MusaMahmood/PCB_nRF52_GSR_recharge/GSR_v1.kicad_pcb

## KiCad design GSR_v1.kicad_pcb (2019-05-02)

Schematic: GSR_v1.sch

Parts:
A1: CHIP-ANT
C1, C9, C10, C14, C15: 10uF; C_0402
C2: 22uF; C_0402
C3, C4, C5, C26, C33: 100nF; C_0402
C6, C7, C8, C11: 0.1uF; C_0402
C16, C17: 4.7uF; C_0402
C18: 1.0uF; C_0402
C21: 4.7µF; C_0402
C22: 100nF; C_0603
C23: 1.0µF; C_0603
C24, C25, C28, C29: 12pF; C_0402
C27: N.C.
C30: 1.0pF; C_0402
C34: 100pF; C_0402
D1, D3: LED; LED_0603
D4: D_Schottky; LED_0603
F1: 2450FM07A0029
IC1: AD5242BRUZ1M; SOP65P640X120-16N; Mouser Part Number 584-AD5242BRUZ1M
J1: Micro_SD_Card_Det
L1: 2.20µH; L_0603
L2: 4.7uH; L_0603
L3: 15nH; L_0402
L4: 10uH; L_0603
L5: 2.7nH; L_0402
L6: 3.9nH; L_0402
P1, P2, P3, P4: CONN_2; Pin_Header_Straight_1x02_Pitch2.54mm
Q1: DMP21D5UFB4-7B; X2-DFN1006
R1, R2, R4, R16, R17, R18, R19: 4.7k; R_0402
R3, R6, R13, R14: 200k; R_0402
R5, R7, R15: 1M; R_0402
R8: N.C.; R_0402
R9: 2k; R_0402
R10, R11, R12: 100k; R_0402
R20: 1k; R_0402
S1: SSAJ120100; Mouser Part Number 688-SSAJ120100
U1: TPS63001
U2: LM324N
U3: NRF528XX-QFAA; UQFN-48-1EP_6x6mm_Pitch0.4mm
U4: TMP116
U5: TPS2294x
U6: MCP73831; DFN-8-1EP_2x3mm_Pitch0.5mm
U7: ADS1220; QFN-16-1EP_3x3mm_P0.5mm_EP1.8x1.8mm
U8: TPS61222; SOT-363_SC-70-6
U9: 4050; SOIC127P600X175-16N
X1: Crystal_GND24; Crystal_SMD_2016-4pin_2.0x1.6mm
X2: 32.768 kHz; Crystal_SMD_2012-2pin_2.0x1.2mm

Connections:
5V_in_charge: C16.1, D4.2, P3.1, Q1.1, R10.1, U6.1 (Vdd), U6.2 (Vdd)
/AD5242_SCL: IC1.7, R19.1, U3.21 (P0.18/TD[0]/SWO)
/AD5242_SDA: IC1.8, R4.1, U3.20 (P0.17)
/ADC_AIN0: C5.2, R15.1, U7.9
/AIN_BAT_DIV_VOLTAGE: R5.1, R7.2, U3.6 (P0.04/AIN2)
/BATT_IN: C17.1, P1.1, Q1.2, U6.3 (Vbat), U6.4 (Vbat)
/CMD_MOSI: U3.28 (P0.23), U9.3
/DAT0_MISO: J1.7, U3.24 (P0.21/nRESET)
/DAT1_UNUSED: J1.8
/DAT2_UNUSED: J1.1
/DAT3_CS: R20.1, U3.29 (P0.24), U9.9
/DEC1: C26.1, U3.1 (DEC1)
/DEC2: C27.1, U3.32 (DEC2)
/DEC3: C34.1, U3.33 (DEC3)
/DIN: U3.16 (P0.13), U7.14
/DOUT: U3.17 (P0.14/TRACEDATA[3]), U7.13
/ELECTRODE_INPUT: IC1.3, P4.1, U2.5 (+)
/LOAD_IN: C15.1, C18.2, D4.1, Q1.3, R8.2, S1.1, U5.5 (Vin)
/LOAD_SW_CTRL: U3.5 (P0.03/AIN1), U5.4 (ON)
/RF: C30.1, F1.4 (OUT)
/RT_1: C3.2, IC1.2, R1.1, R2.2, R3.2
/SPI_SCLK: U3.15 (P0.12), U7.15
/SPI_~CS: U3.14 (P0.11), U7.16
/SWDCLK: P2.1, U3.25 (SWDCLK)
/SWDIO: P2.2 (PM), U3.26 (SWDIO)
/TMP_ALERT: R18.1, U4.3 (ALERT)
/TMP_SCL: R17.1, U3.22 (P0.19), U4.1 (SCL)
/TMP_SDA: R16.1, U3.23 (P0.20/TRACECLK), U4.6 (SDA)
/uSD_CLK: U3.27 (P0.22), U9.5, U9.7
/~DRDY: U3.18 (P0.15/TD[2]), U7.12
AVDD: C8.1, C10.1, U7.10, U8.2 (FB), U8.4 (VOUT)
DGND: C1.2, C2.2, C3.1, C4.2, C5.1, C6.1, C7.2, C8.2, C9.2, C10.2, C11.2, C14.2, C15.2, C16.2, C17.2, C18.1, C21.1, C22.2, C23.2, C24.1, C25.1, C26.2, C27.2, C28.2, C29.2, C33.1, C34.2, F1.1 (GND), F1.3 (GND), IC1.4, IC1.9, IC1.10, IC1.11, IC1.12, J1.6, J1.9, J1.10, J1.11, L5.2, P1.2 (PM), P3.2 (PM), P4.2 (PM), R2.1, R6.1, R7.1, R9.2, R10.2, R13.2, S1.4, S1.5, U1.3 (PGND), U1.9 (GND), U1.11 (THERMAL), U2.11 (V-), U3.31 (VSS), U3.45 (VSS), U3.49 (THERMAL), U4.2 (GND), U4.4 (ADD0), U4.7 (THRM), U5.2 (GND), U6.6 (Vss), U6.9 (EP_THRM), U7.1, U7.2, U7.3, U7.8, U7.17, U8.3 (GND), U9.8, U9.11, U9.14, X1.2, X1.4
DVDD: C2.1, C4.1, C6.2, C7.1, C11.1, C21.2, C22.1, C33.2, D3.2 (A), IC1.5, IC1.6, J1.4, R1.2, R4.2, R16.2, R17.2, R18.2, R19.2, U1.1 (VOUT), U1.10 (FB), U2.4 (V+), U3.13 (VDD), U3.36 (VDD), U3.48 (VDD), U4.5 (V+), U7.11, U9.1
unnamed: A1.1 (ANT), L6.2
unnamed: C14.1, R5.2, U5.1 (Vout)
unnamed: C23.1, L3.2, U3.46 (DEC4)
unnamed: C24.2, U3.34 (XC1), X1.1
unnamed: C25.2, U3.35 (XC2), X1.3
unnamed: C28.1, U3.2 (P0.00/XL1), X2.2
unnamed: C29.1, U3.3 (P0.01/XL2), X2.1
unnamed: C30.2, L5.1, L6.1
unnamed: D1.1 (K), R20.2
unnamed: D1.2 (A), U9.6
unnamed: D3.1 (K), U6.5 (STAT)
unnamed: F1.2 (IN), U3.30 (ANT)
unnamed: J1.2, U9.10
unnamed: J1.3, U9.2
unnamed: J1.5, U9.4
unnamed: L1.1, U1.4 (L1)
unnamed: L1.2, U1.2 (L2)
unnamed: L2.1, U8.5 (L)
unnamed: L3.1, L4.2
unnamed: L4.1, U3.47 (DCC)
unnamed: R3.1, R6.2, U2.3 (+)
unnamed: R8.1, U5.3 (OC)
unnamed: R9.1, U6.8 (PROG)
unnamed: R11.1, U2.1, U2.2 (-)
unnamed: R11.2, R14.1, U2.9 (-)
unnamed: R12.1, U2.6 (-), U2.7
unnamed: R12.2, R13.1, U2.10 (+)
unnamed: R14.2, R15.2, U2.8
VCC: C1.1, C9.1, L2.2, S1.3, U1.5 (VIN), U1.6 (EN), U1.7 (PS/SYNC), U1.8 (VINA), U8.1 (VIN), U8.6 (EN)

Notes on the sheet:
This network will need to be tuned
No reverse polarity protection; use caution and do not connect battery and debugger at same time!
Power Regulation Circuitry
Vcc = Raw battery signal
Vout
TPS22941
MAY DISCONNECT OUTPUT OC PIN!!! HIGH VOLTAGE MAY DMG NRF CHIP. REMOVE R8 ON PCB;
Load Sharing Circuit
Q1 = DMP21D5UFB4 P-mosfet Footprint: X2-DFN1006-3
D4 = SMD Schottky Diode (0603)
TO LOAD
R9 sets current limit NOTE: STAT PIN IS 5V
GSR Analog Front End (Using 4-Op Amp LM324-N Configured as Instrumentation Amp)
Temperature Sensor IC
nRF52 Module
LOAD_IN = Vcc = Battery Voltage
Recharge Circuitry
Load Switch for Battery Measurement with Voltage Divider (V/2)
3.3V Voltage Regulator, 2A Max output
Pin Headers and General Connection Labeling
MicroSD Card
5.0 V Regulator
reference
ADC
Digital Potentiometer
Switch
Use 16-Pin SOIC Package

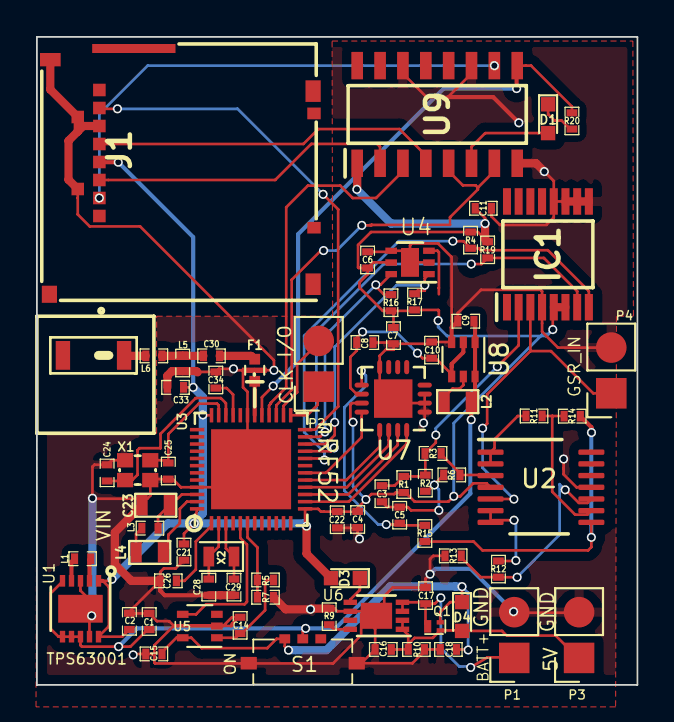
[picture p1: board GSR_v1.kicad_pcb from above]

Board: 2 copper layers, 33.4 x 36.0 mm, 75 parts (0 on the bottom side), 57 nets.
