MusaMahmood/PCB_nRF52_GSR_recharge/(threads)

Thread 2 (2019-03-28):

Errors on branch digital_potentiometer_adc

MusaMahmood, 2019-03-28:
- [x] Need to connect SHDN pin to VDD
- [x] Fix ADS1220 footprint. It is 3.5 x 3.5mm not 3.0 x 3.0 mm.

Closed 2019-04-22.

Thread 3 (2019-04-22):

Error on I2C bus

MusaMahmood, 2019-04-22:
Devices AD5242 and TMP116 should be on the same bus, not taking up 4 lines.
