MusaMahmood/PCB_nRF52_GSR_recharge/(commit log)

2018-08-30 Initial commit. Design incomplete.
    [ExG_ADS1292_v4-B.Cu.gbl, ExG_ADS1292_v4-B.Mask.gbs, ExG_ADS1292_v4-B.SilkS.gbo, ExG_ADS1292_v4-Edge.Cuts.gm1, ExG_ADS1292_v4-F.Cu.gtl, ExG_ADS1292_v4-F.Mask.gts, ExG_ADS1292_v4-F.SilkS.gto, ExG_ADS1292_v4.drl]
2018-08-31 Upgraded to KiCAD 5.0 compat
    [GSR_v1.kicad_pcb, GSR_v1.sch]
2018-08-31 Updated footprint for LM324
    [GSR_v1.kicad_pcb]
2018-08-31 Nathan edits and my finalization to PCB design.
    [GSR_v1.kicad_pcb]
2018-09-02 Fixed missing connections, resolved issues.
    [GSR_v1.kicad_pcb]
2018-09-04 Major refactoring and cleanup.
    [GSR_v1.sch]
2018-09-04 Updated Gerbers, deleted old gerber files, minor details. Updated silkscreen (back)
    [ExG_ADS1292_v4-B.Cu.gbl, ExG_ADS1292_v4-B.Mask.gbs, ExG_ADS1292_v4-B.SilkS.gbo, ExG_ADS1292_v4-F.Cu.gtl, ExG_ADS1292_v4-F.Mask.gts, ExG_ADS1292_v4-F.SilkS.gto, GSR_v1-B.Cu.gbl, GSR_v1-B.Mask.gbs]
2018-09-04 Fixed F.Silk to show orientation of TSSOP.
    [GSR_v1-B.Cu.gbl, GSR_v1-B.Mask.gbs, GSR_v1-B.SilkS.gbo, GSR_v1-Edge.Cuts.gm1, GSR_v1-F.Cu.gtl, GSR_v1-F.Mask.gts, GSR_v1-F.SilkS.gto, GSR_v1-NPTH.drl]
2019-01-09 moved connectors for Temp sensor down to make space for uSD card
    [GSR_v1.kicad_pcb, GSR_v1.sch]
2019-01-09 Added microSD Card to sch and pcb
    [GSR_v1.kicad_pcb, GSR_v1.sch]
2019-01-09 Added ground plane under micoSD slot
    [GSR_v1.kicad_pcb]
2019-01-09 Slight tweaking, set fills to DGND.
    [GSR_v1.kicad_pcb]
2019-01-09 Updated Gerber files, fixed back silkscreen
    [GSR_v1-B.Cu.gbl, GSR_v1-B.Mask.gbs, GSR_v1-B.SilkS.gbo, GSR_v1-Edge.Cuts.gm1, GSR_v1-F.Cu.gtl, GSR_v1-F.Mask.gts, GSR_v1-F.SilkS.gto, GSR_v1-NPTH.drl]
2019-01-11 Replaced through-hole footprints with pads.
    [GSR_v1-B.Cu.gbl, GSR_v1-B.Mask.gbs, GSR_v1-B.SilkS.gbo, GSR_v1-Edge.Cuts.gm1, GSR_v1-F.Cu.gtl, GSR_v1-F.Mask.gts, GSR_v1-F.SilkS.gto, GSR_v1-NPTH.drl]
2019-03-13 Updated schematic, and footprints. PCB needs arrangement and routing.
    [GSR_v1.kicad_pcb, GSR_v1.sch]
2019-03-14 Added switch and arranged and routed PCB.
    [GSR_v1.kicad_pcb, GSR_v1.sch]
2019-03-28 Fixed routing of AD5242.
    [GSR_v1.kicad_pcb, GSR_v1.sch]
2019-03-28 Fixed SHDN pin to VDD.
    [GSR_v1.kicad_pcb, GSR_v1.sch]
2019-04-01 Fixed footprint for ADS1220.
    [GSR_v1-B.Cu.gbl, GSR_v1-B.Mask.gbs, GSR_v1-B.SilkS.gbo, GSR_v1-Edge.Cuts.gm1, GSR_v1-F.Cu.gtl, GSR_v1-F.Mask.gts, GSR_v1-F.SilkS.gto, GSR_v1-NPTH.drl]
2019-05-02 Updated digital potentiometer ADC
    [GSR_v1-B.Cu.gbl, GSR_v1-B.Mask.gbs, GSR_v1-B.SilkS.gbo, GSR_v1-Edge.Cuts.gm1, GSR_v1-F.Cu.gtl, GSR_v1-F.Mask.gts, GSR_v1-F.SilkS.gto, GSR_v1-NPTH.drl]
2019-05-02 Updated schematic with new hex buffers for driving uSD Card.
    [GSR_v1.kicad_pcb, GSR_v1.sch]
2019-05-02 Update bottom solder mask, and gerber files.
    [GSR_v1-B.Cu.gbl, GSR_v1-B.Mask.gbs, GSR_v1-B.SilkS.gbo, GSR_v1-Edge.Cuts.gm1, GSR_v1-F.Cu.gtl, GSR_v1-F.Mask.gts, GSR_v1-F.SilkS.gto, GSR_v1-NPTH.drl]
